ara-daq-hw/ara-smart-power-supply/README.md

# ara-smart-power-supply
Master repository for the ARA Smart Power Supply. Hardware, submodules containing firmware, software, etc. all are here.
