ara-daq-hw/ara-smart-power-supply/Hardware/ASPS-POWER/ARA_SMART_POWER_SYSTEM_MK_III.pdf

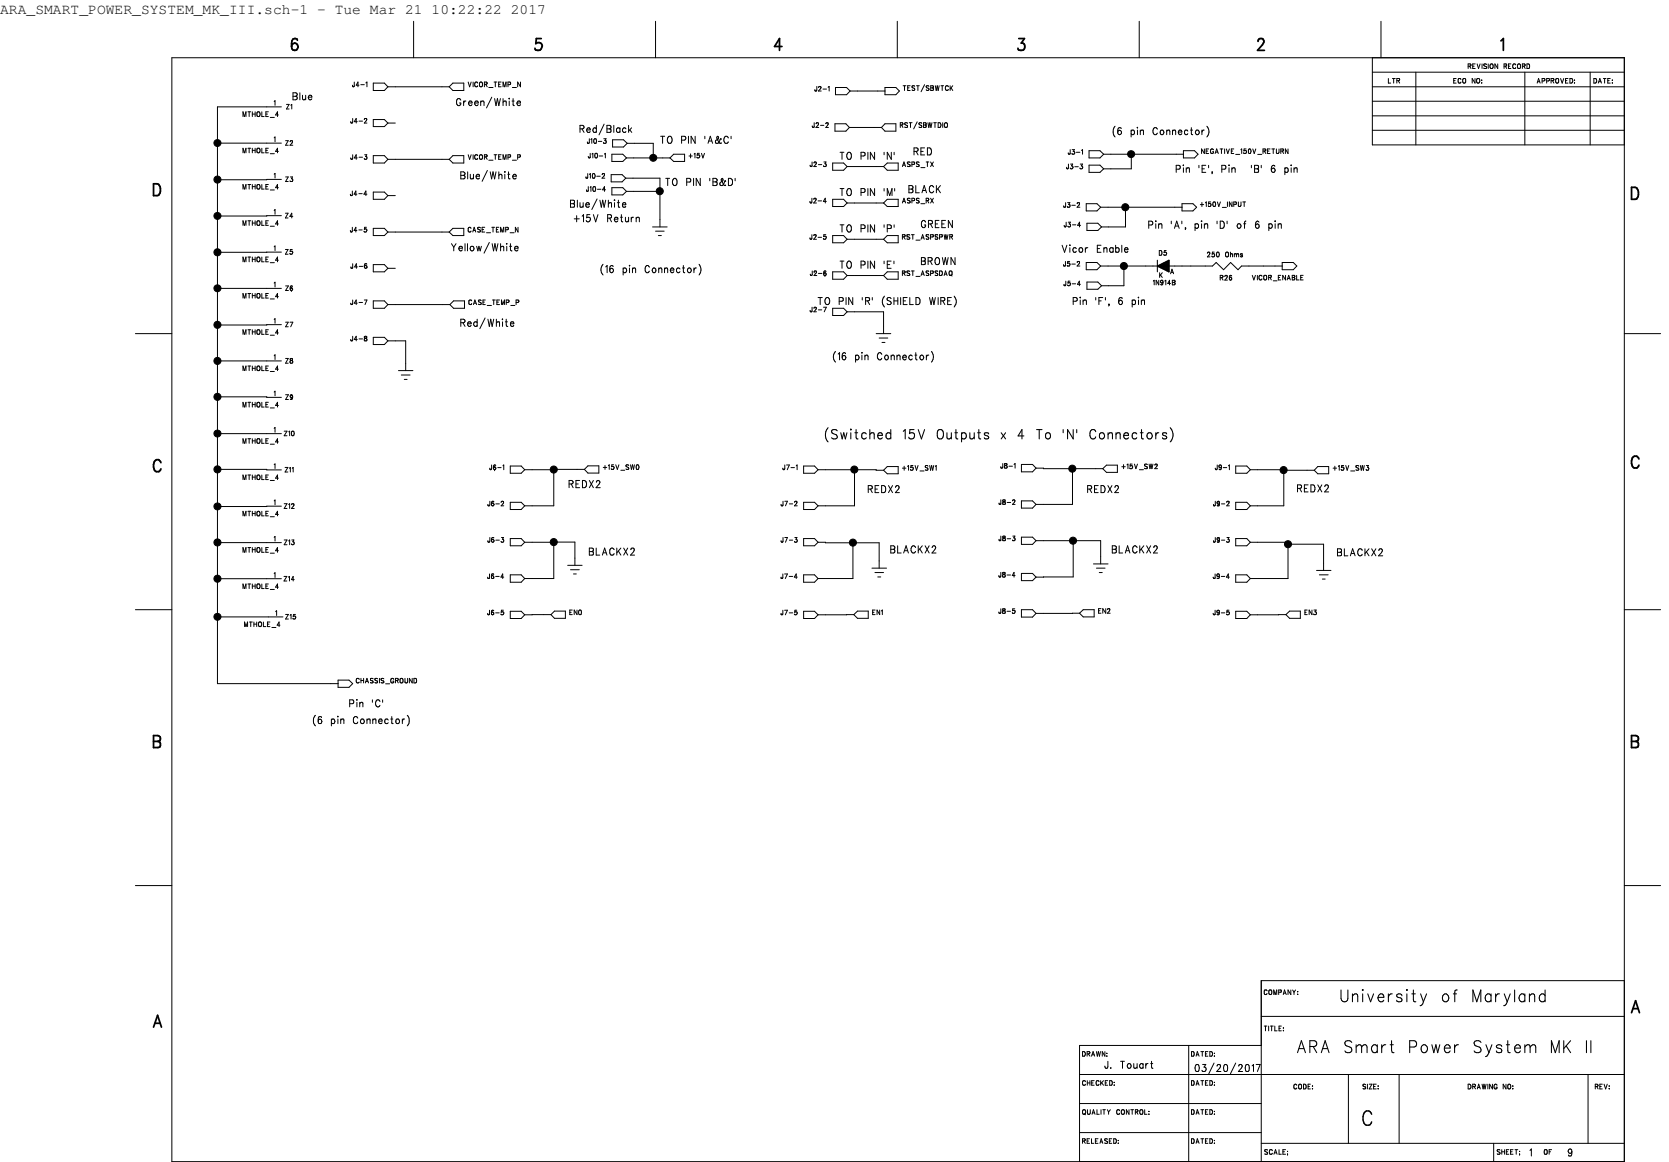
[picture p5: page 1]

ARA_SMART_POWER_SYSTEM_MK_III.sch-1 - Tue Mar 21 10:22:22 2017

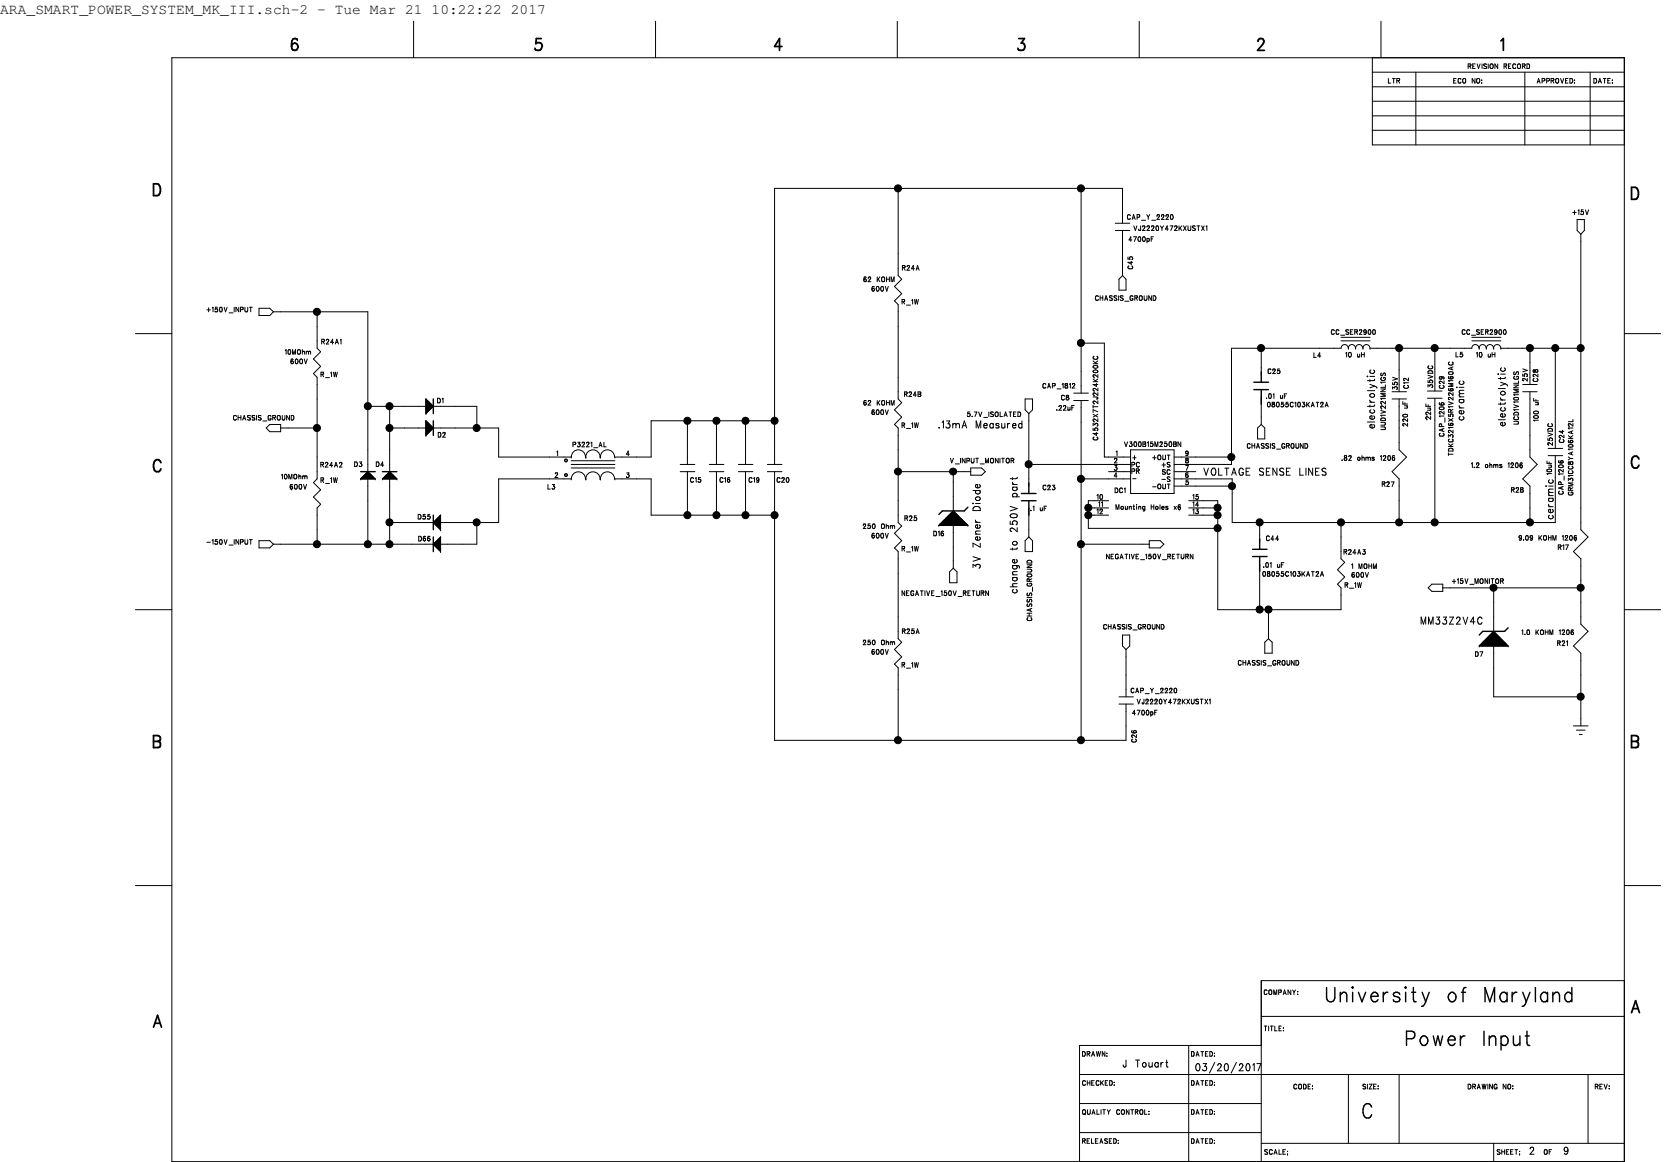
[picture p6: page 2]

ARA_SMART_POWER_SYSTEM_MK_III.sch-2 - Tue Mar 21 10:22:22 2017

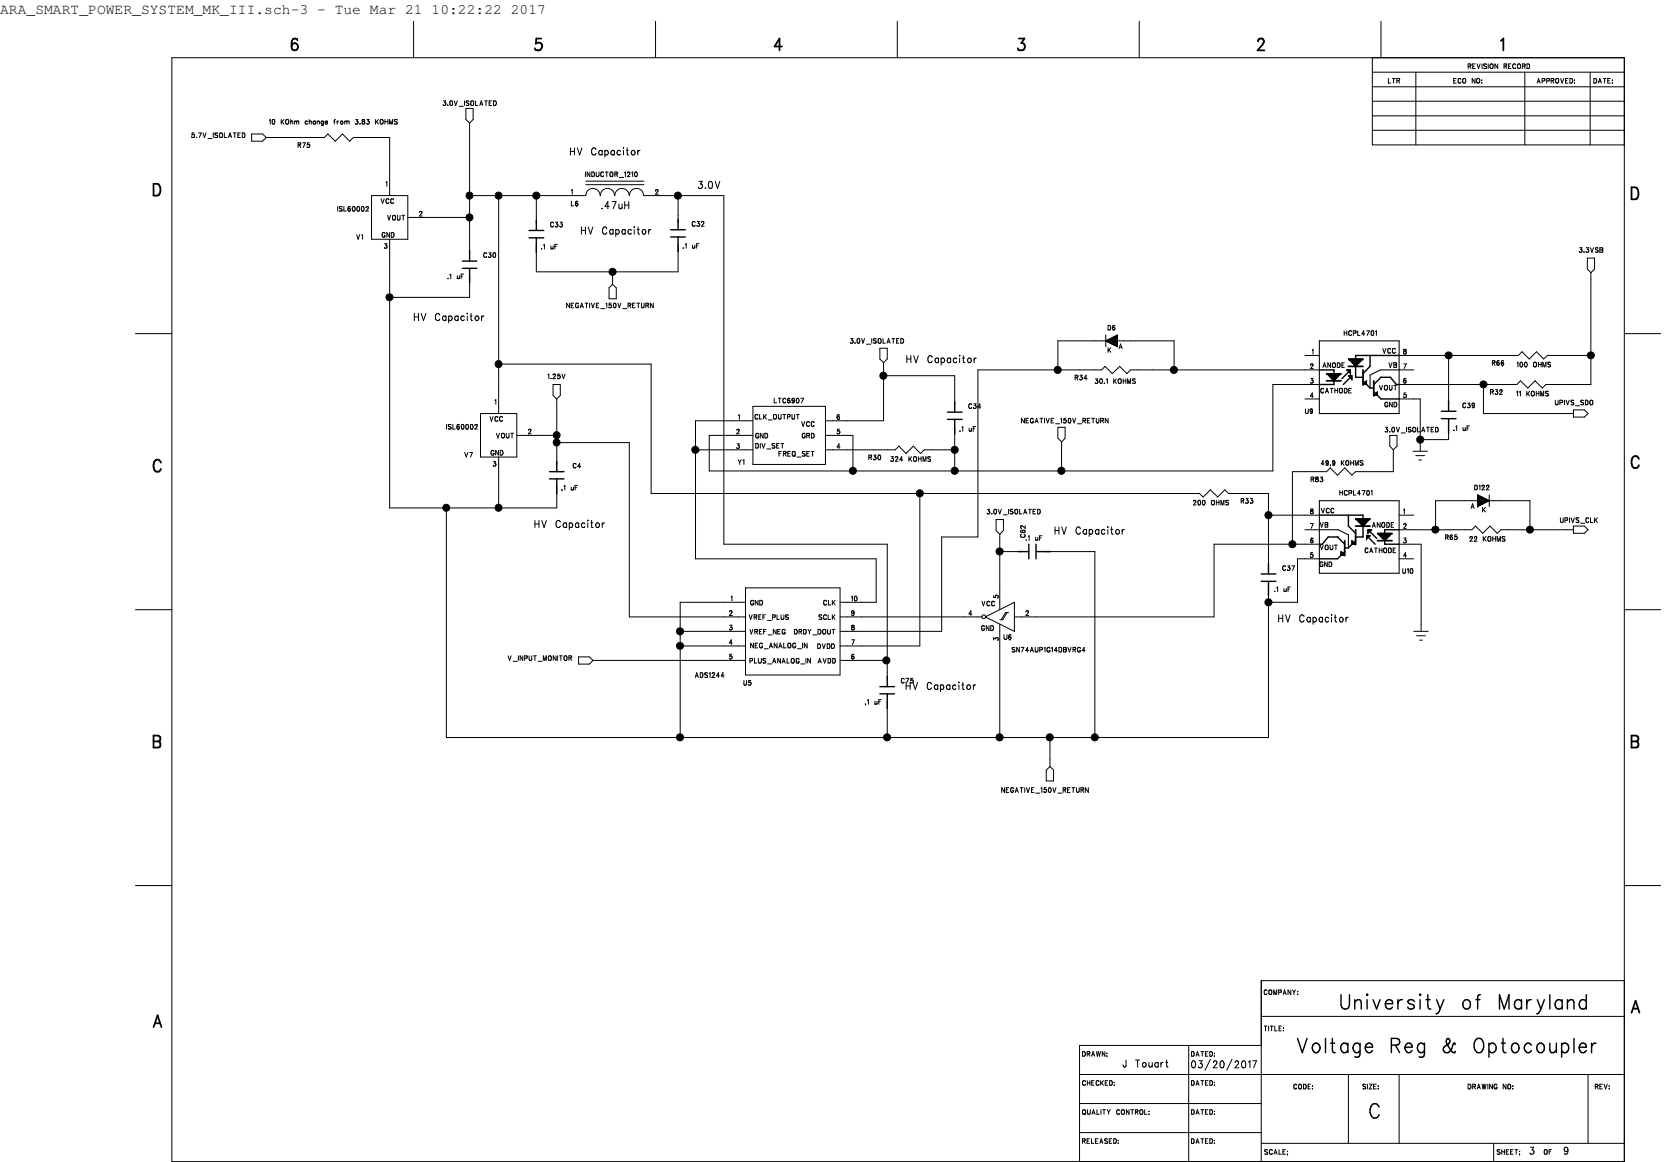
[picture p7: page 3]

ARA_SMART_POWER_SYSTEM_MK_III.sch-3 - Tue Mar 21 10:22:22 2017

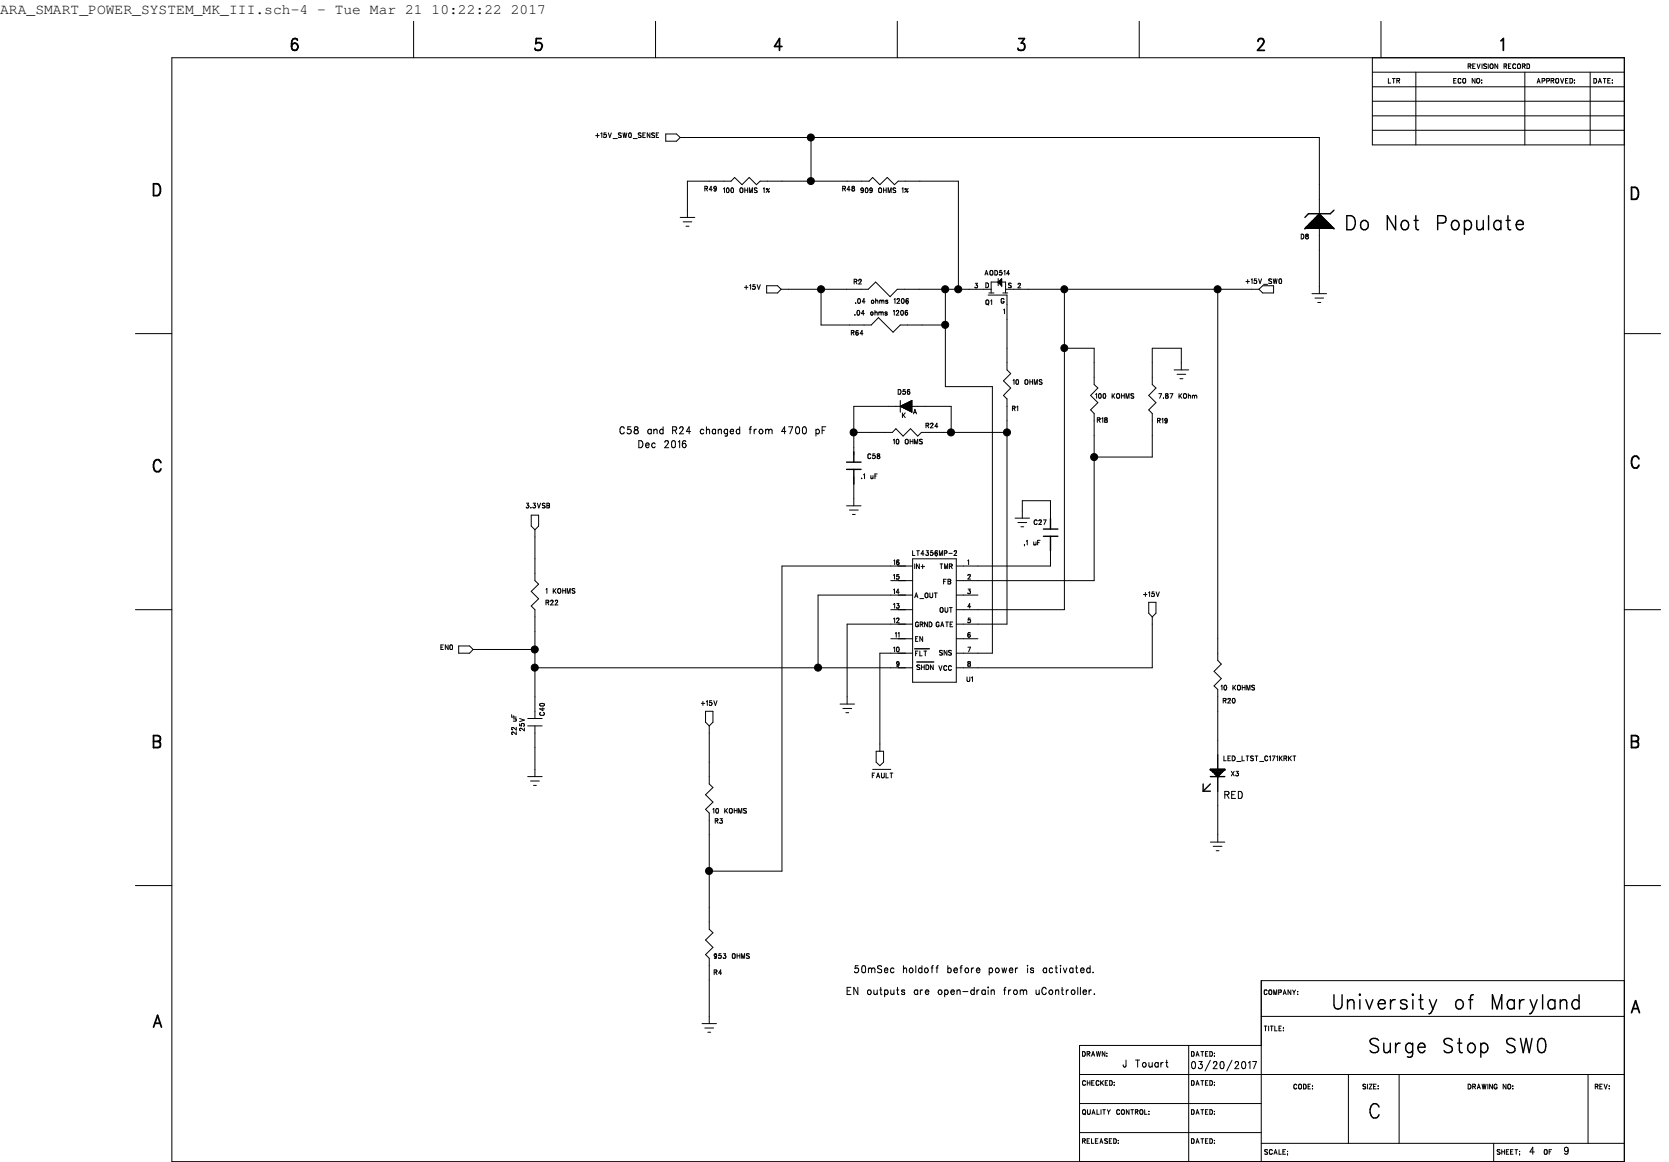
[picture p8: page 4]

ARA_SMART_POWER_SYSTEM_MK_III.sch-4 - Tue Mar 21 10:22:22 2017

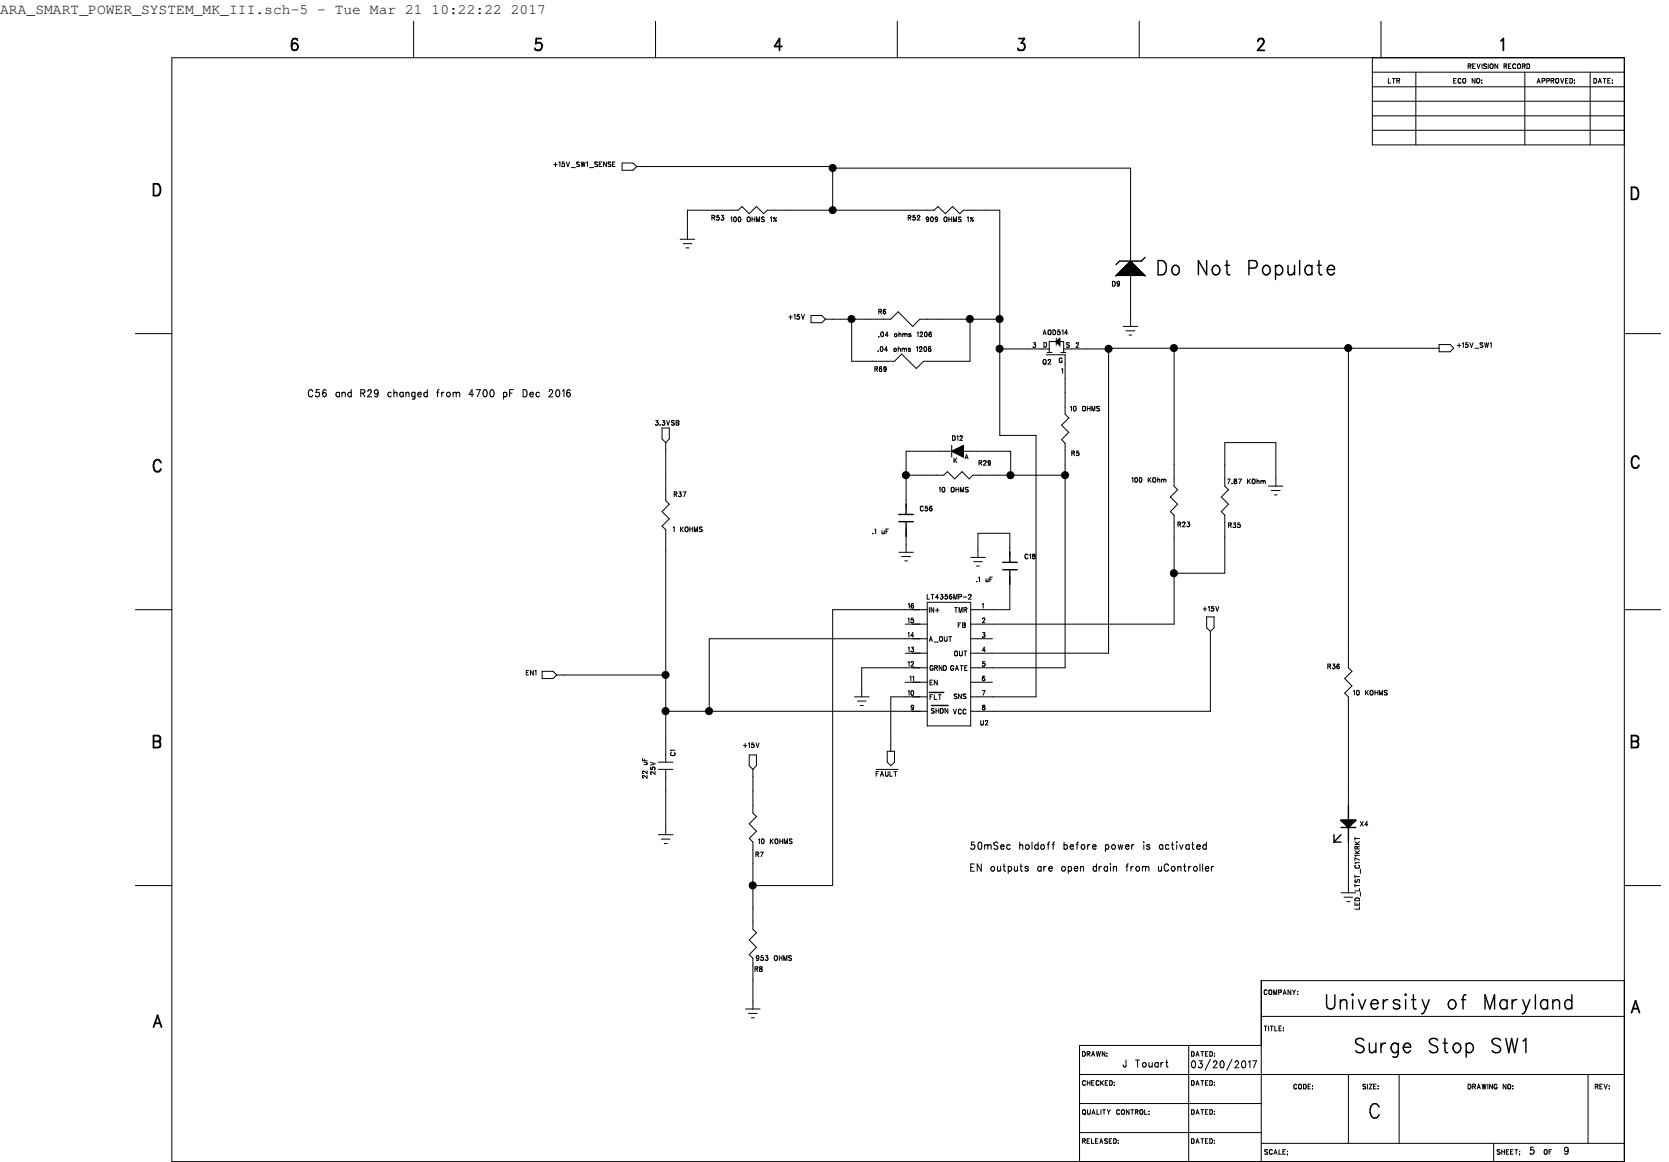
[picture p9: page 5]

ARA_SMART_POWER_SYSTEM_MK_III.sch-5 - Tue Mar 21 10:22:22 2017

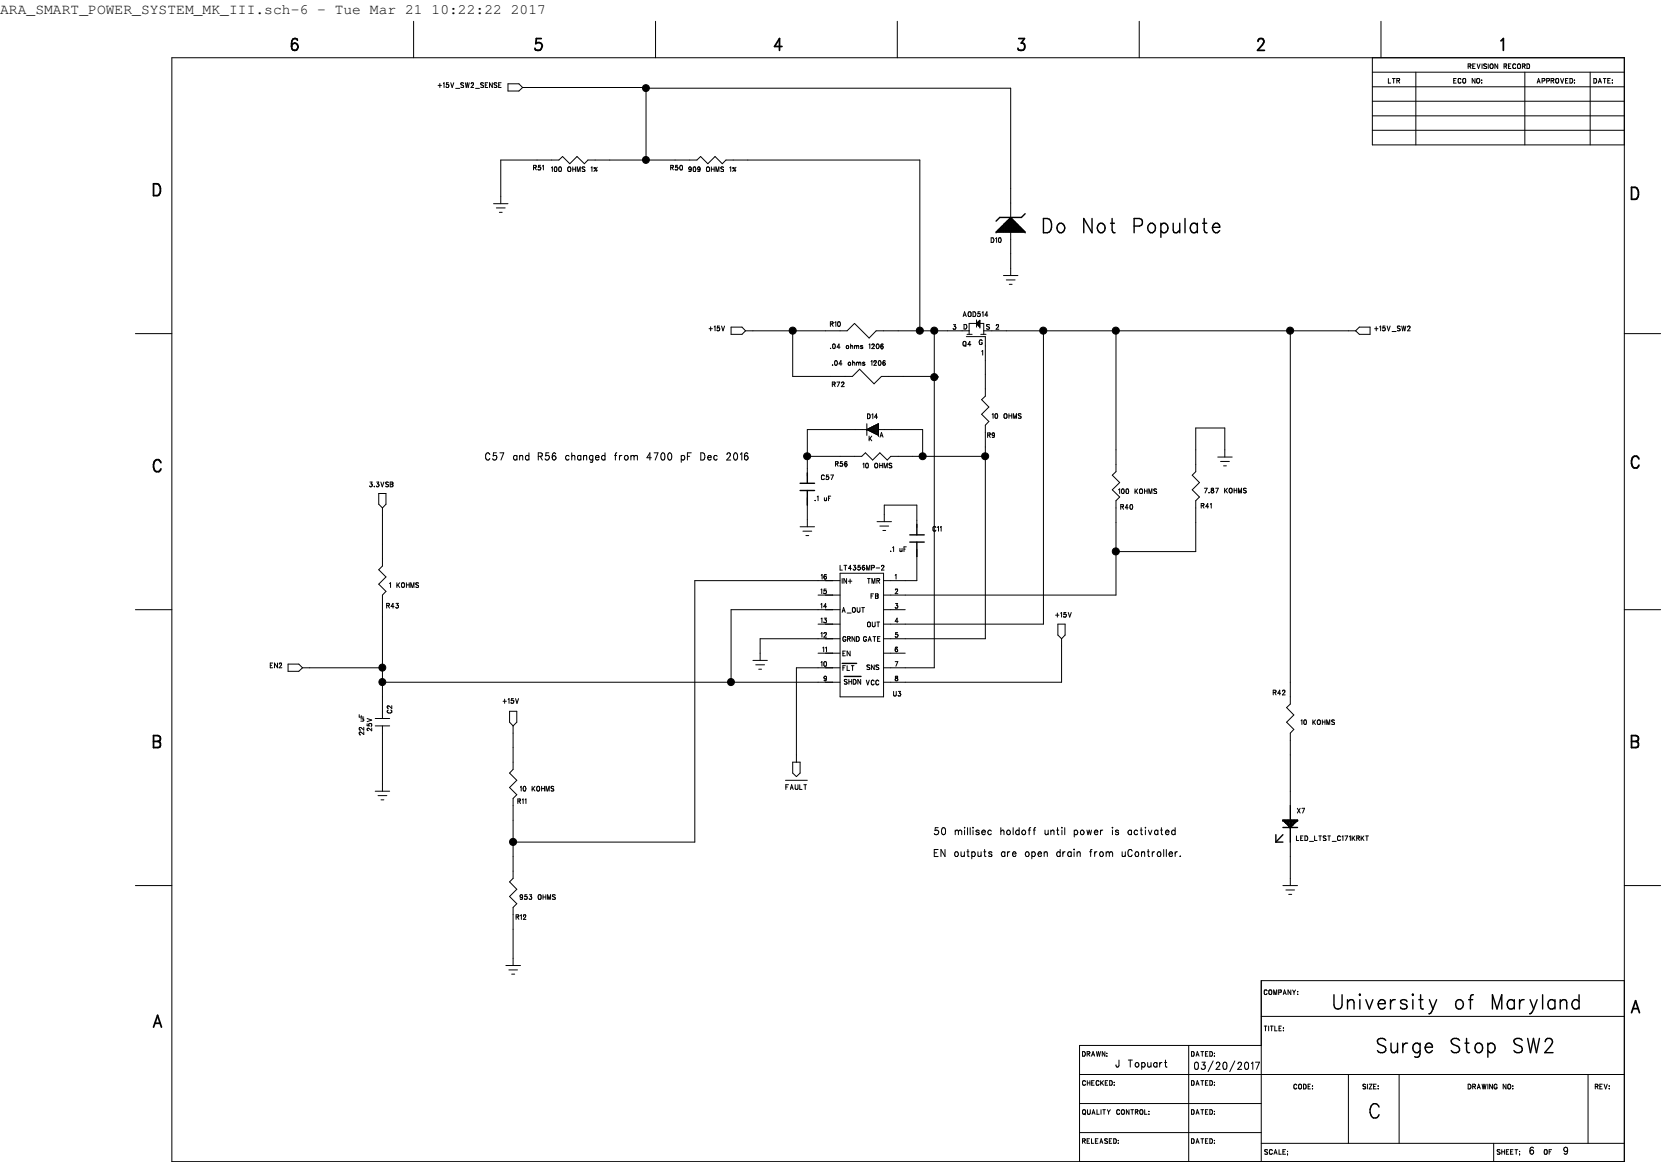
[picture p10: page 6]

ARA_SMART_POWER_SYSTEM_MK_III.sch-6 - Tue Mar 21 10:22:22 2017

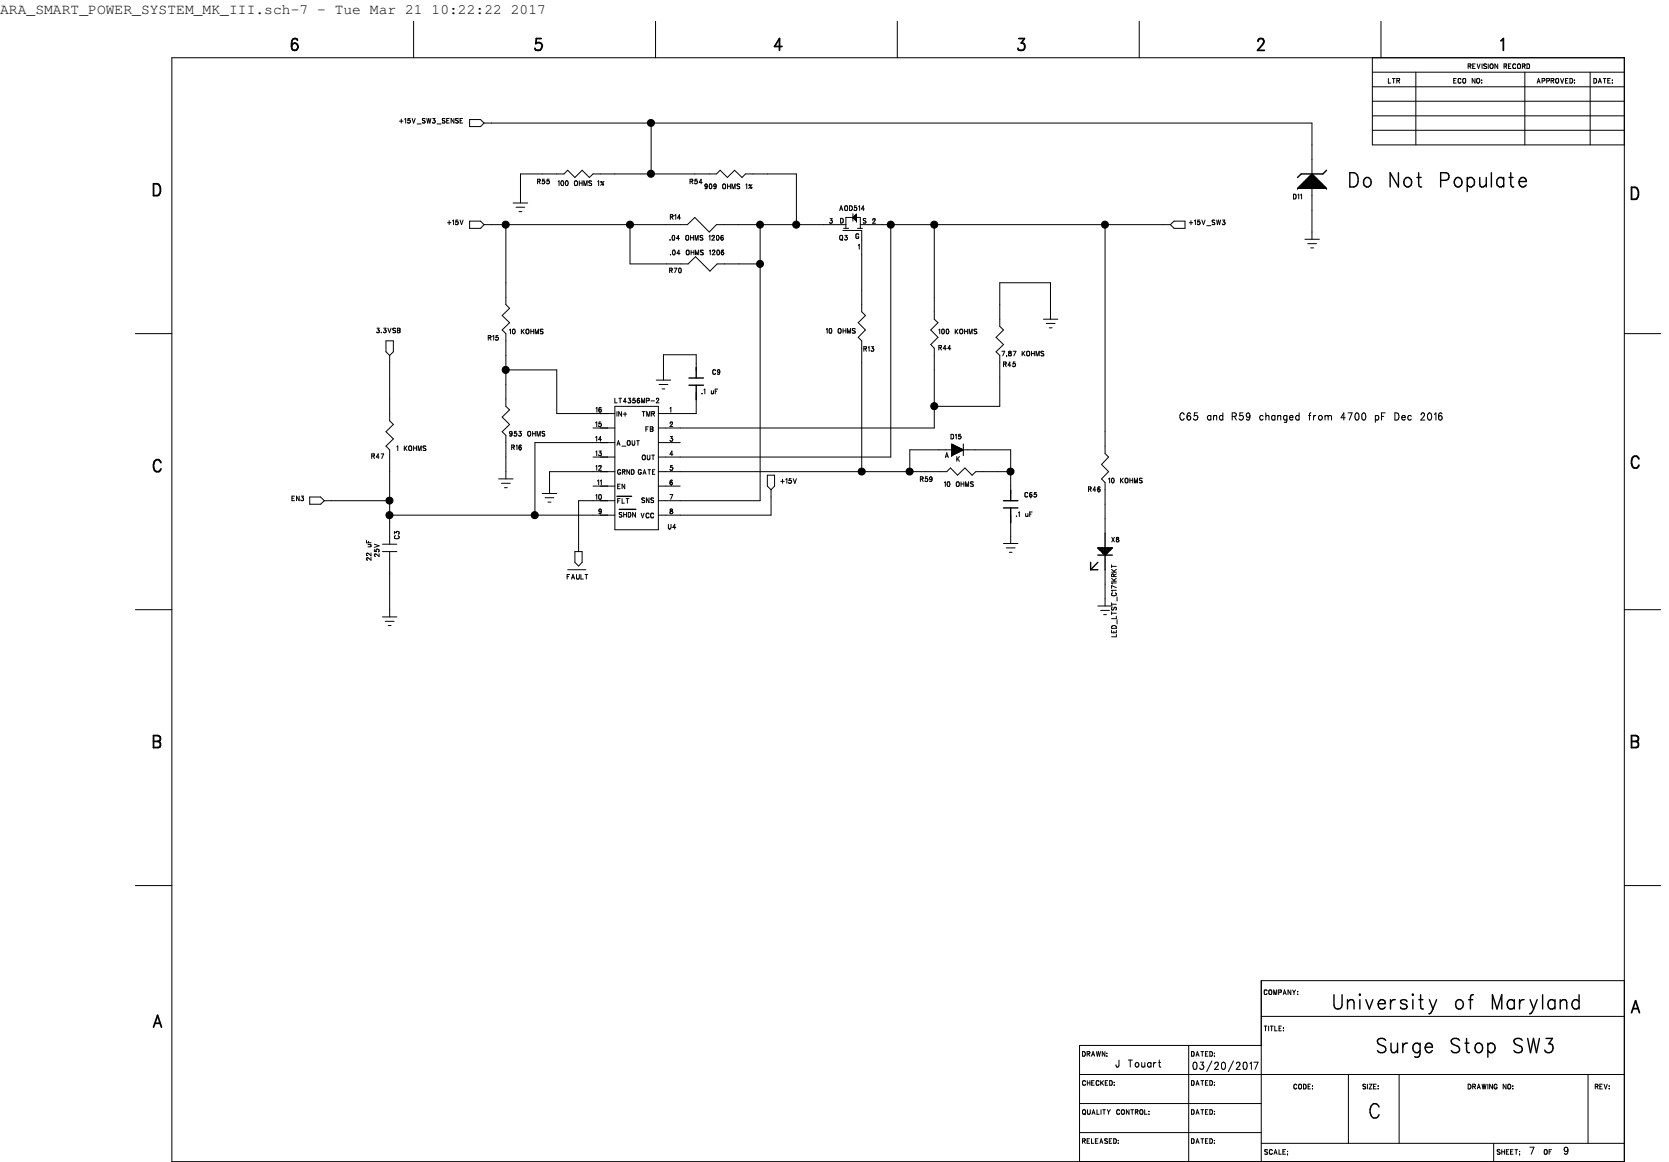
[picture p11: page 7]

ARA_SMART_POWER_SYSTEM_MK_III.sch-7 - Tue Mar 21 10:22:22 2017

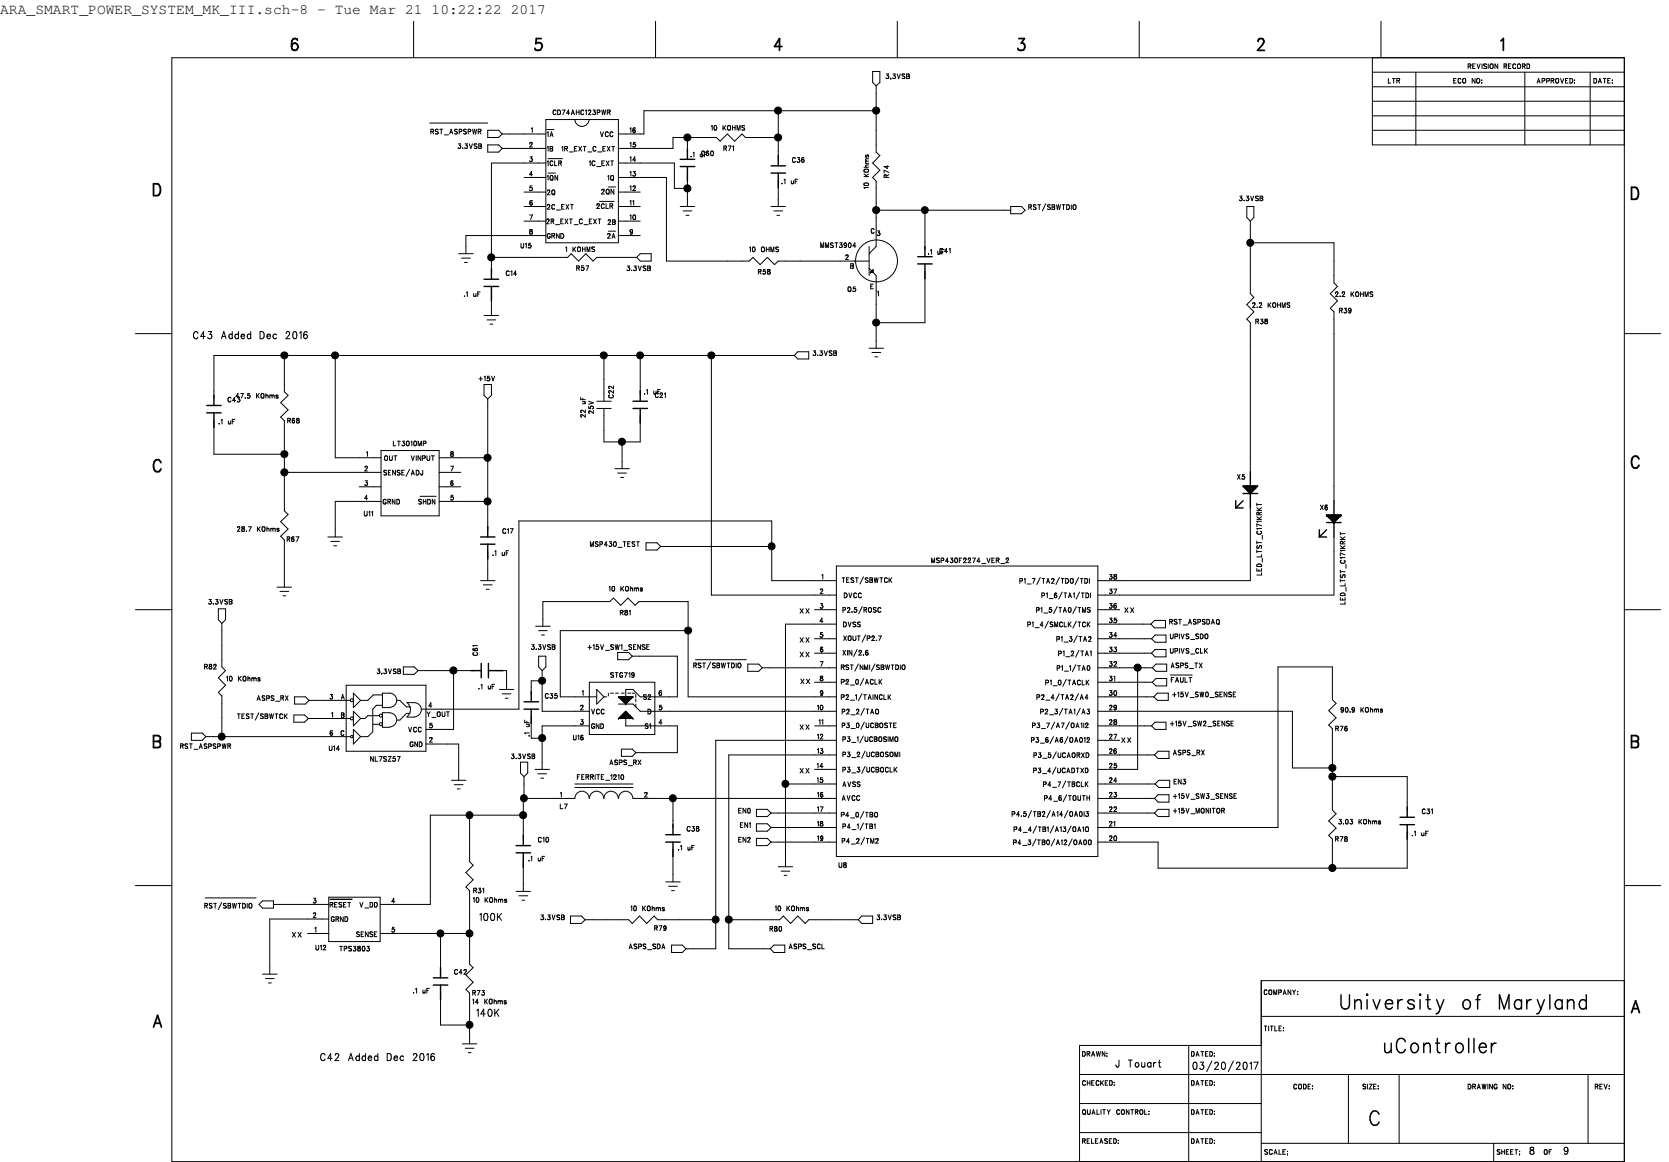
[picture p12: page 8]

ARA_SMART_POWER_SYSTEM_MK_III.sch-8 - Tue Mar 21 10:22:22 2017

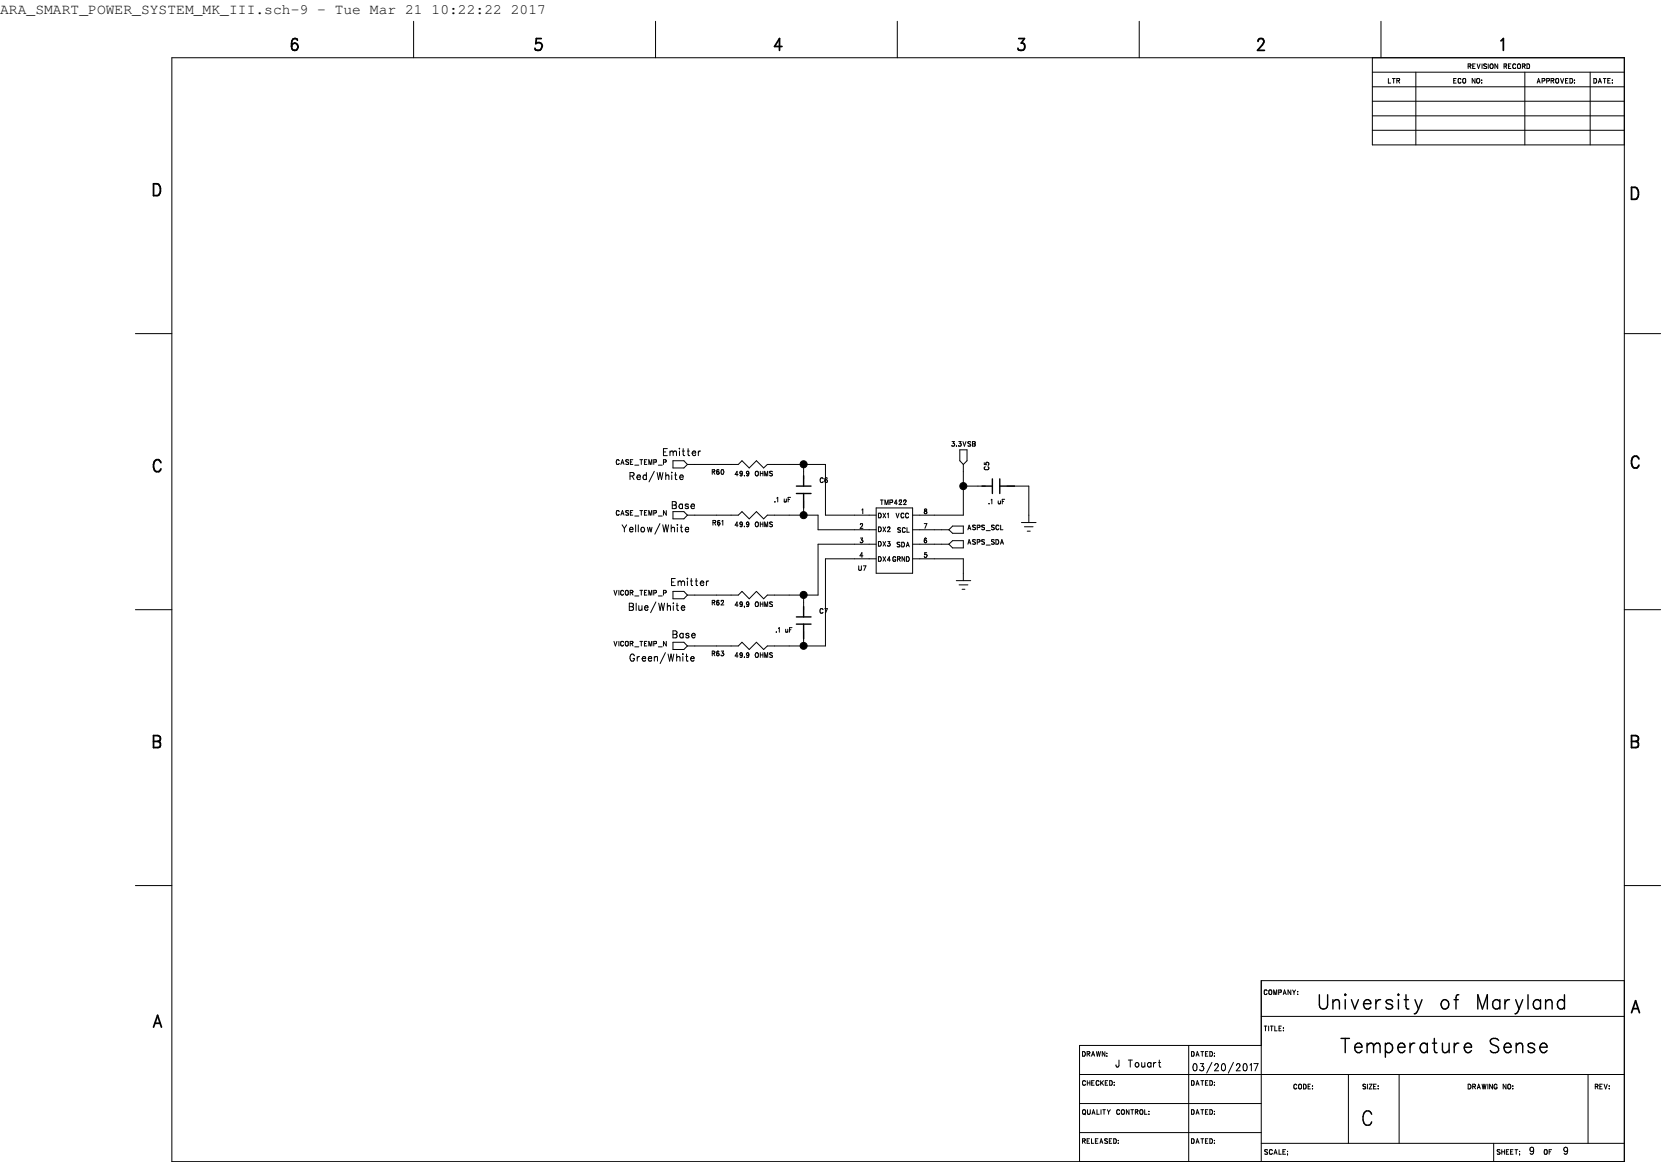
[picture p13: page 9]

ARA_SMART_POWER_SYSTEM_MK_III.sch-9 - Tue Mar 21 10:22:22 2017
