ara-daq-hw/ara-smart-power-supply/(list of files, drawings)

Other design files:
Hardware/ASPS-DAQ/revF/ASPS_DAQv5p2.pcb
