ara-daq-hw/ara-smart-power-supply/(commit log)

2017-03-03 add revF of ASPS-DAQ. Not current rev, but usable.
    [ASPS_DAQv5p2.pcb, ASPS_DAQv5p2.sch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]
2017-06-23 add ASPS-Power schematic
2017-09-20 update heater parameter definitions
